MechatronixLab/ColorTemp/DOCUMENTS/ColorTemp PCB 3D Render.png

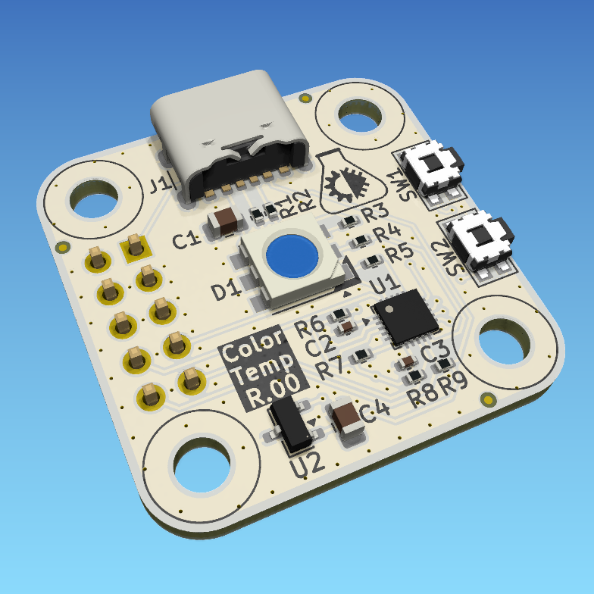
DOCUMENTS/ColorTemp PCB 3D Render.png
