MechatronixLab/ColorTemp/DOCUMENTS/ColorTemp PCB 3D Render Bottom.png

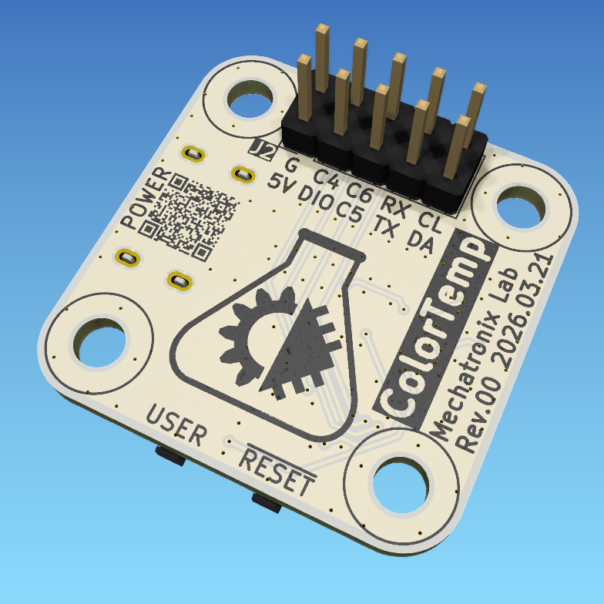
DOCUMENTS/ColorTemp PCB 3D Render Bottom.png
