MechatronixLab/ColorTemp/DOCUMENTS/ColorTemp GitHub Link QR.png

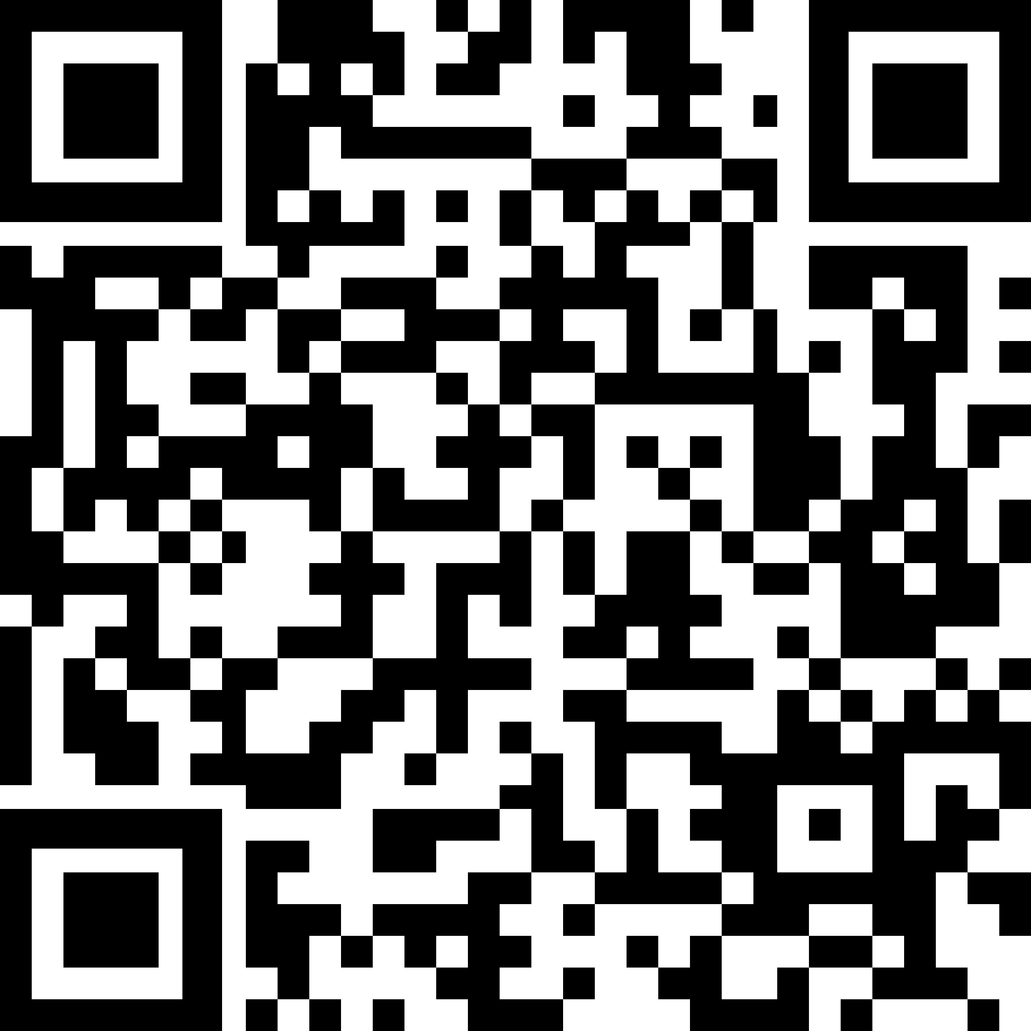
DOCUMENTS/ColorTemp GitHub Link QR.png
