MechatronixLab/ColorTemp/DOCUMENTS/ColorTemp PCB Bottom.png

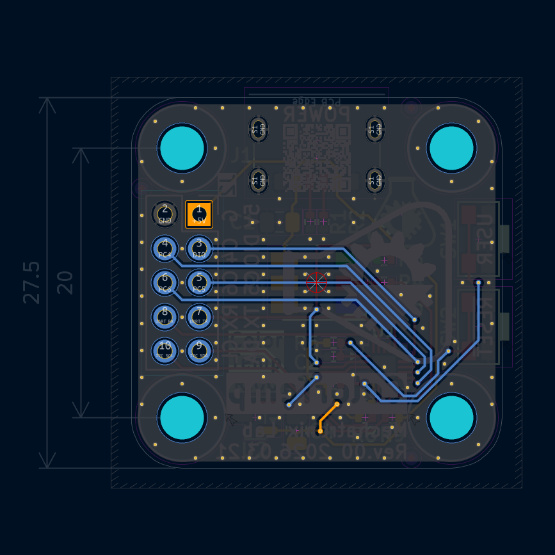
DOCUMENTS/ColorTemp PCB Bottom.png
