MechatronixLab/ColorTemp/DOCUMENTS/ColorTemp PCB Top.png

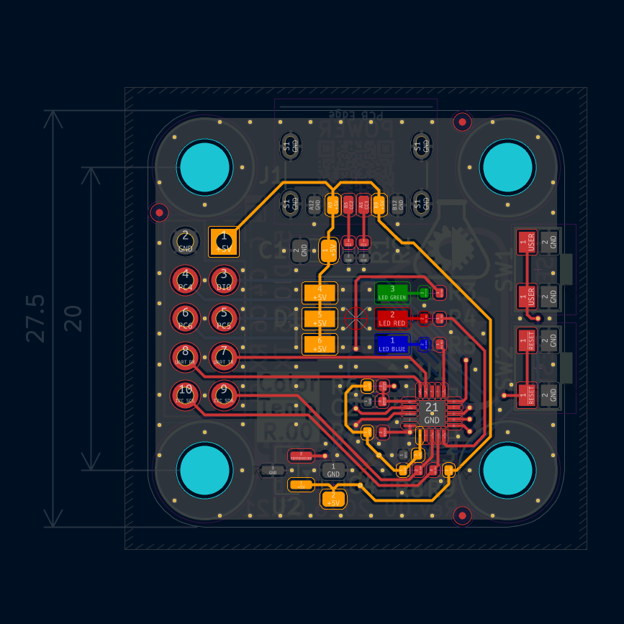
DOCUMENTS/ColorTemp PCB Top.png
