MechatronixLab/ColorTemp/HARDWARE/KICAD/Fabrication/ColorTemp Rev.00 - BOM (JLCPCB).xlsx

Comment | Designator | Footprint | JLCPCB Part # (optional)
10uF 25V | C1,C4 | C_0805_2012Metric | C15850
100nF 50V | C2,C3 | C_0402_1005Metric | C307331
WS2850B | D1 | WS2850B | C4154880
POWER | J1 | USB_C_Receptacle_GCT_USB4125-xx-x-0190_6P_TopMnt_Horizontal | C2927029
5.1K 1% | R1,R2,R6,R7,R8,R9 | R_0402_1005Metric | C25905
220R 1% | R3,R4,R5 | R_0402_1005Metric | C25091
USER | SW1 | EVQP7A01P | C79167
~{RESET} | SW2 | EVQP7A01P | C79167
CH32V003F4U6 | U1 | QFN-20-1EP_3x3mm_P0.4mm_EP1.65x1.65mm | C5299908
MCP9700A | U2 | SOT-23 | C127949
