MechatronixLab/ColorTemp/HARDWARE/KICAD/3D/EVQP7A01P.stp

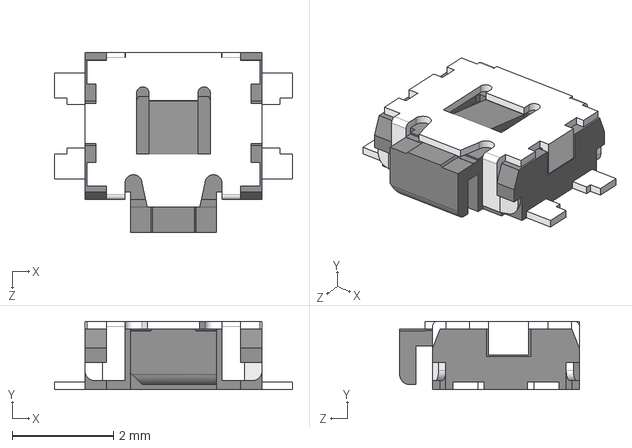
[picture p6: CAD file, 2026-03-14]
HARDWARE/KICAD/3D/EVQP7A01P.stp
4.70 x 1.35 x 3.55 mm
