MechatronixLab/ColorTemp/MECHANICAL/STEP/ColorTemp-PCB-Rev.00.step

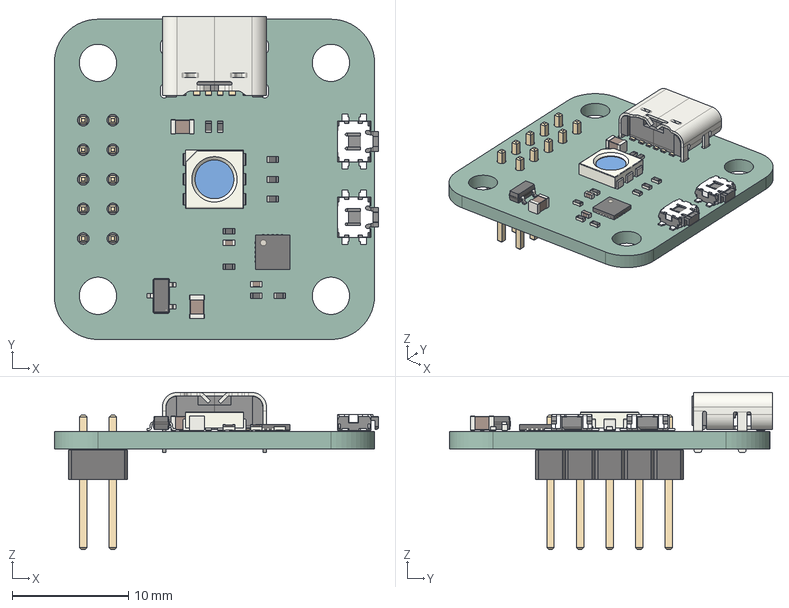
[picture p7: CAD file, 2026-03-14]
MECHANICAL/STEP/ColorTemp-PCB-Rev.00.step
27.9 x 27.7 x 13.5 mm
R_0402_1005Metric x 9
C_0805_2012Metric x 2
LED_RGB_5050-6
C_0402_1005Metric x 2
EVQP7A01P x 2
SOT-23
USB_C_Receptacle_GCT_USB4125-xx-x-0190_6P_TopMnt_Horizontal
UQFN-20-1EP_3x3mm_P0.4mm_EP1.85x1.85mm
PinHeader_2x05_P2.54mm_Vertical
ColorTemp_PCB
