MechatronixLab/ColorTemp/HARDWARE/KICAD/Fabrication/PDF/ColorTemp Rev.00 - SCHEMATIC.pdf

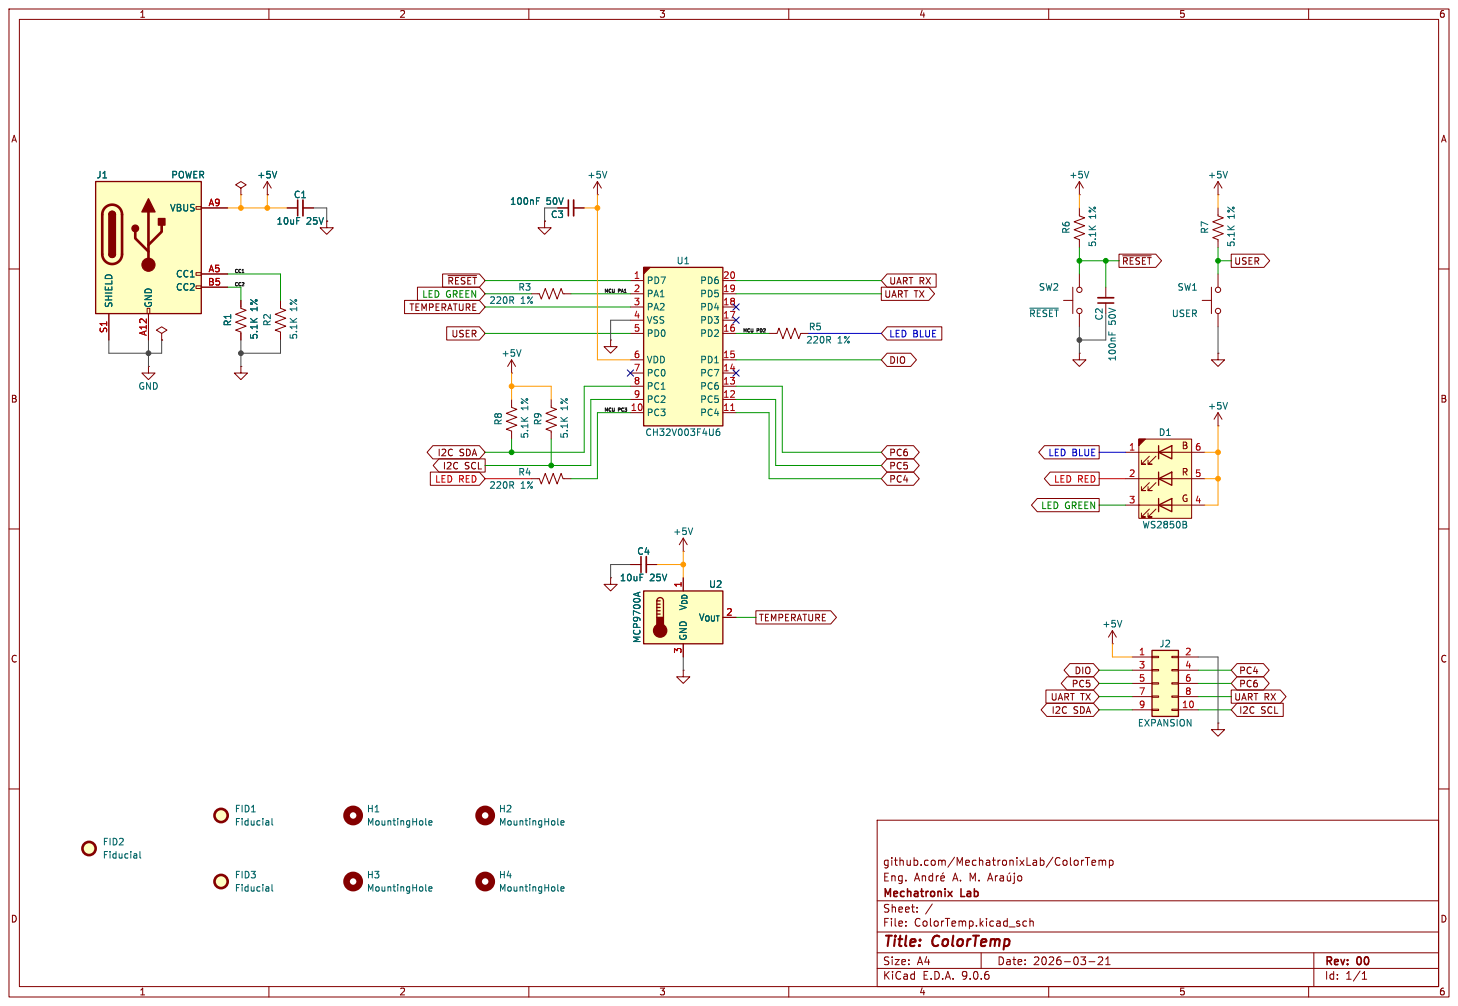
[picture p8: page 1]

I2C SCL PC4 UART RX UART TX

github.com/MechatronixLab/ColorTemp
