MechatronixLab/ColorTemp/HARDWARE/KICAD/Fabrication/PDF/ColorTemp Rev.00 - LAYOUT.pdf

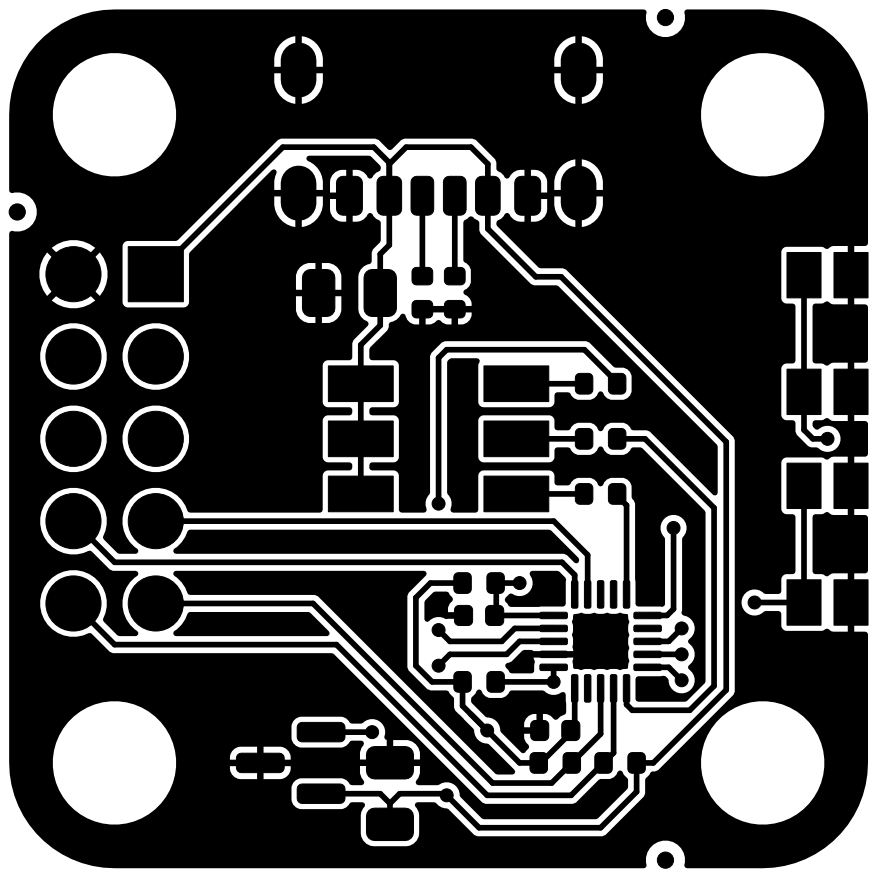
[picture p9: page 1]

github.com/MechatronixLab/ColorTemp

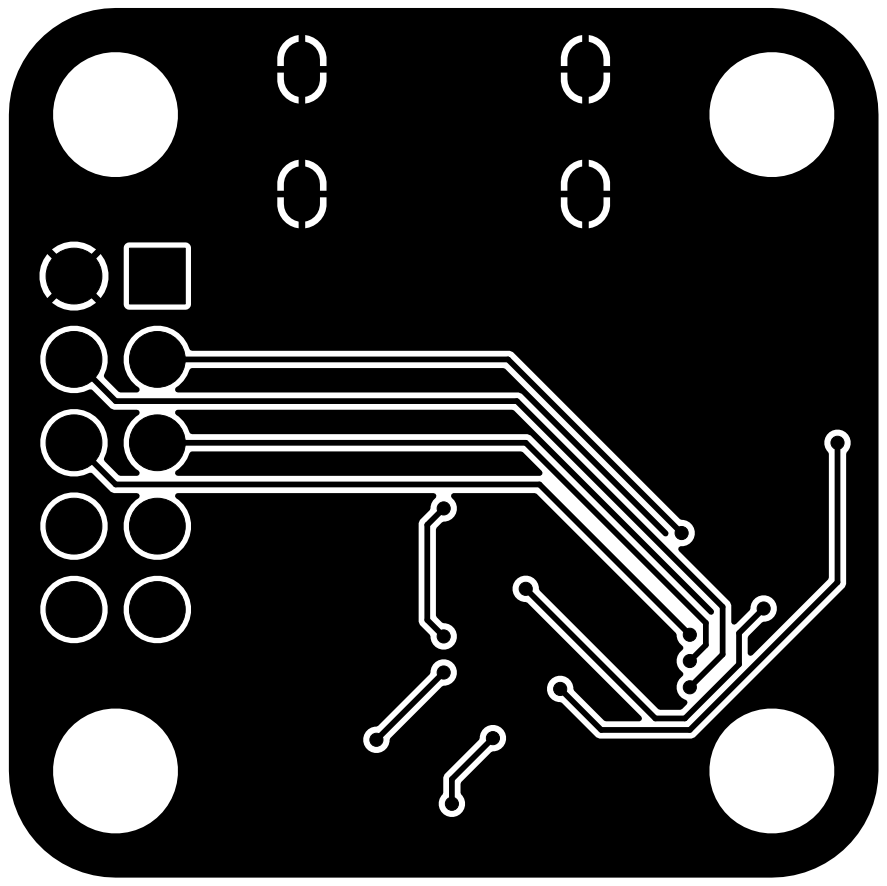
[picture p10: page 2]

github.com/MechatronixLab/ColorTemp

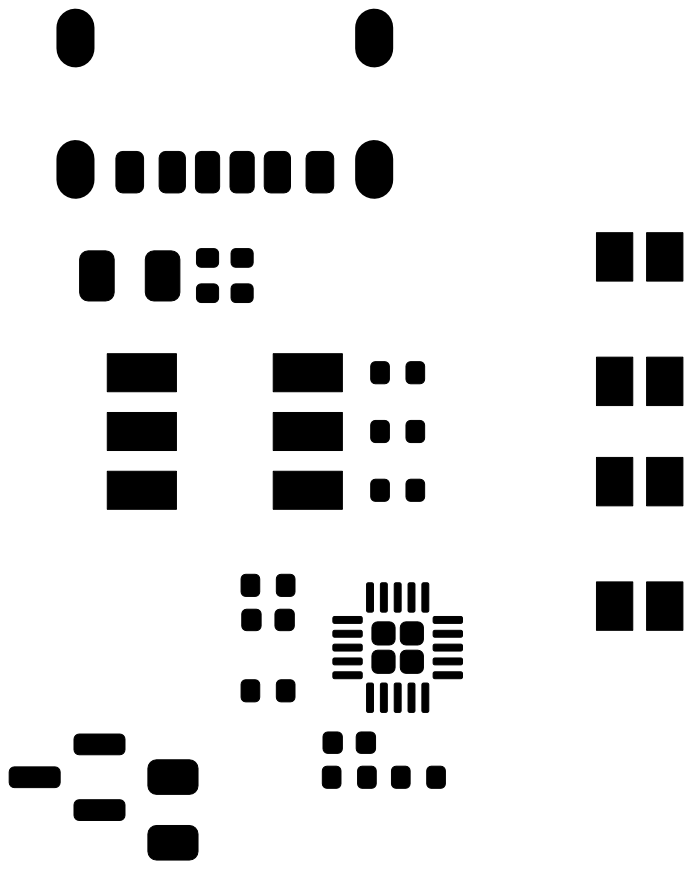
[picture p11: page 3]

github.com/MechatronixLab/ColorTemp

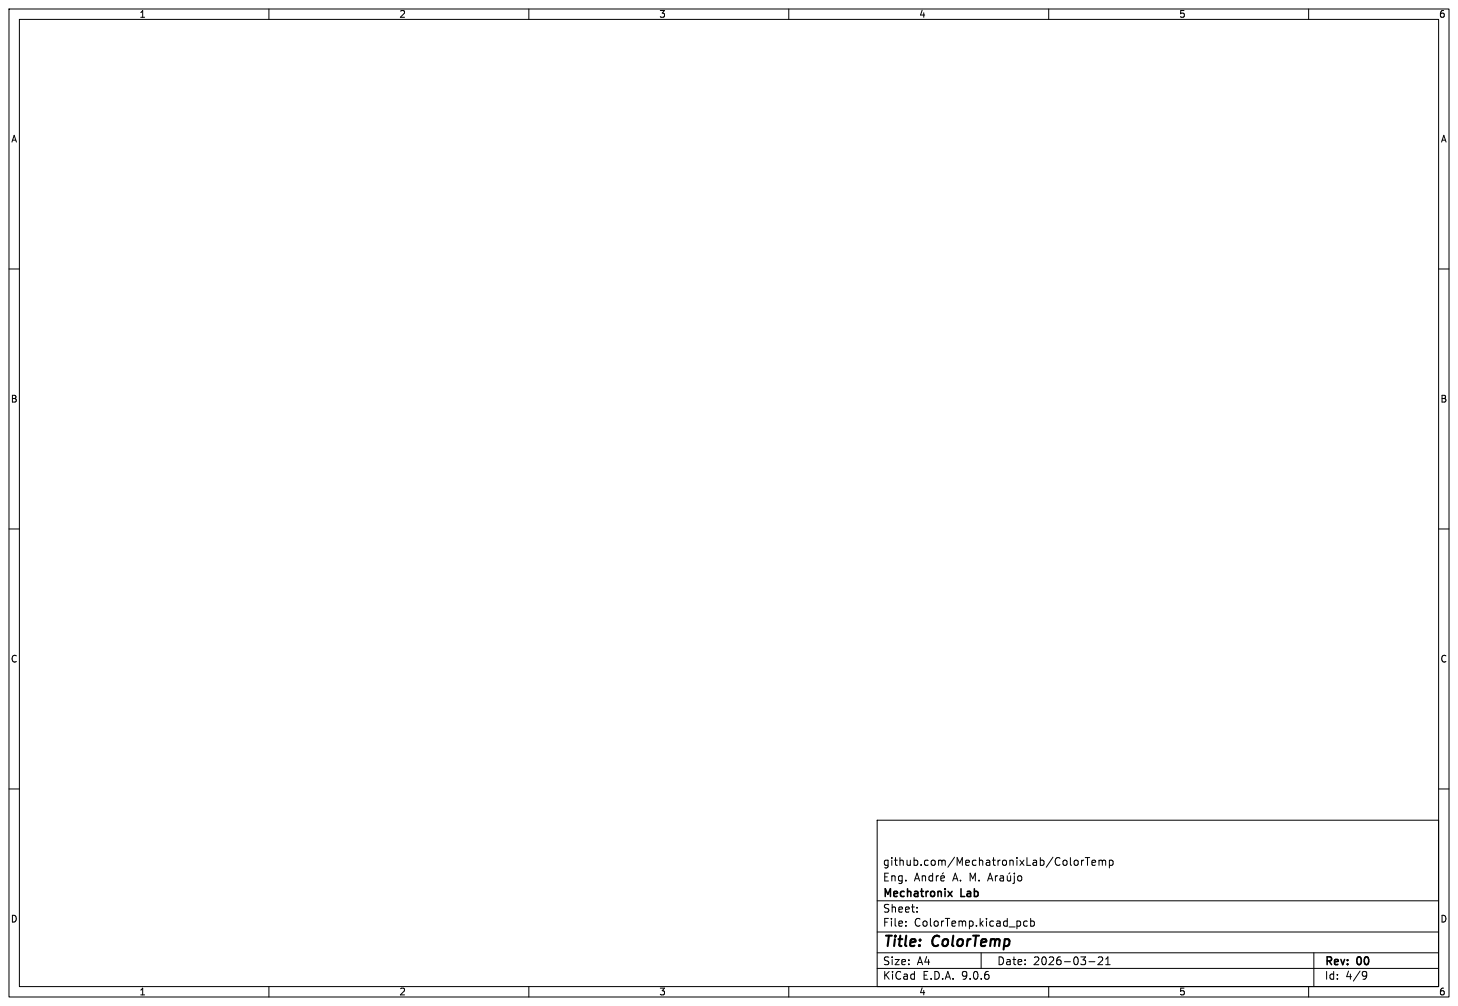
[picture p12: page 4]

github.com/MechatronixLab/ColorTemp

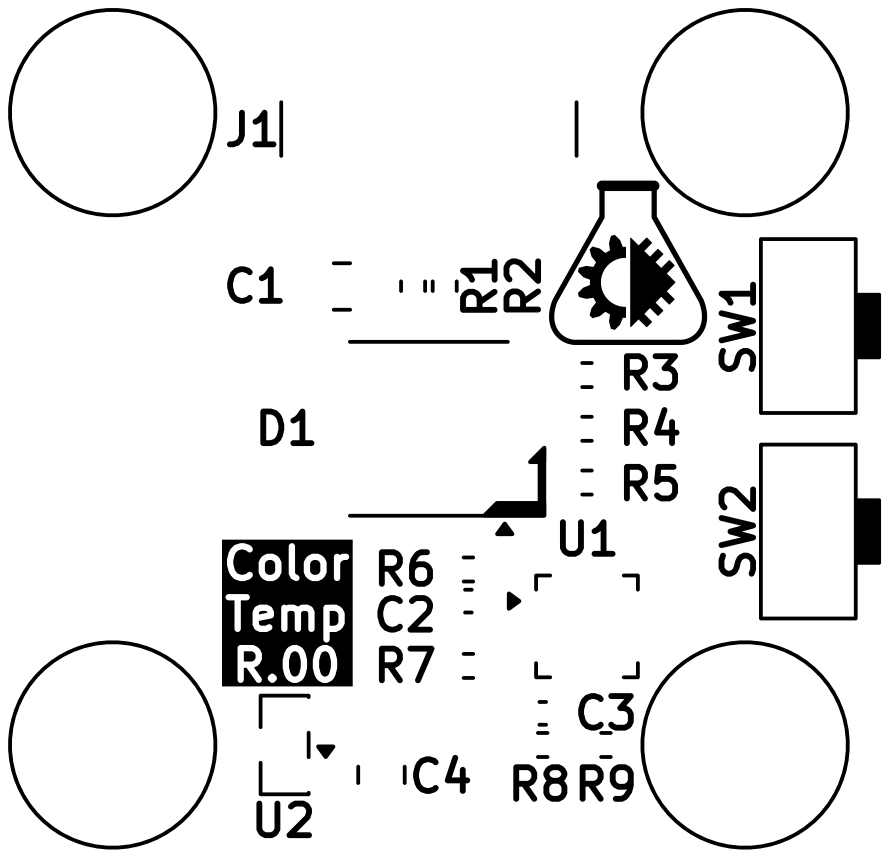
[picture p13: page 5]

github.com/MechatronixLab/ColorTemp

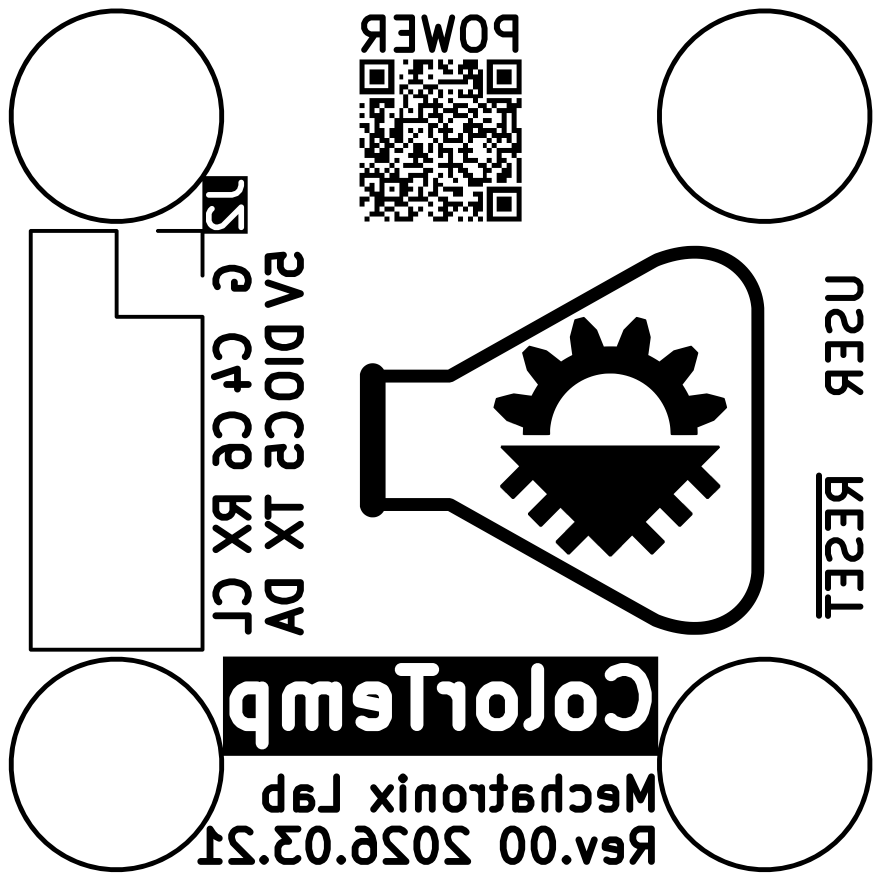
[picture p14: page 6]

github.com/MechatronixLab/ColorTemp

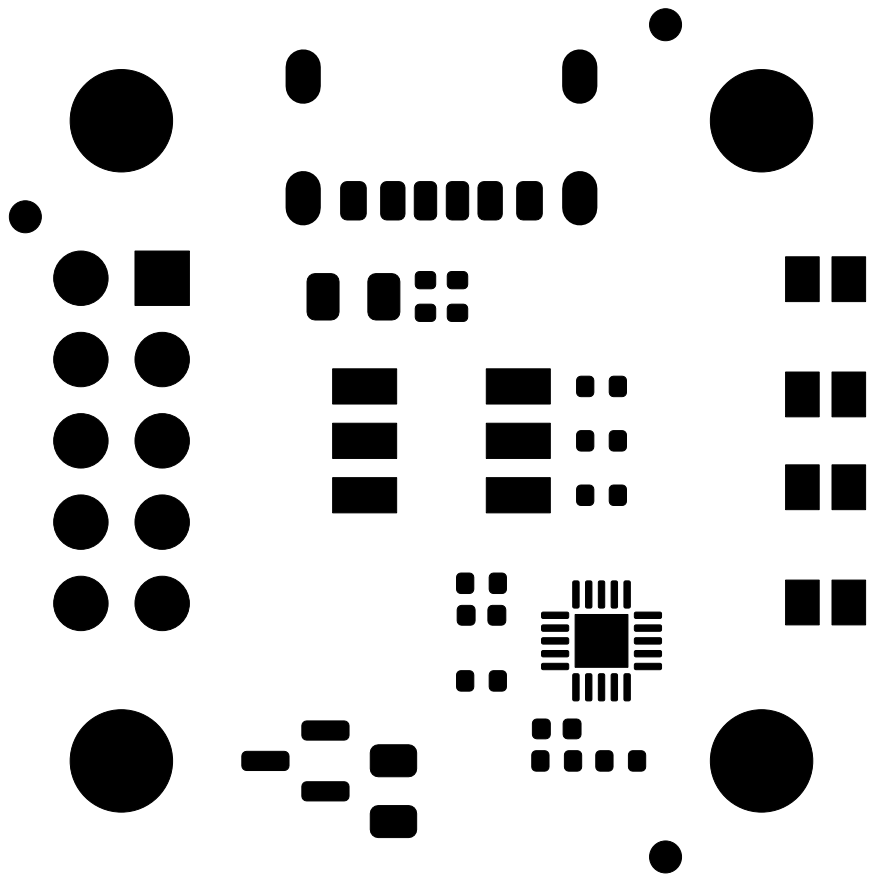
[picture p15: page 7]

github.com/MechatronixLab/ColorTemp

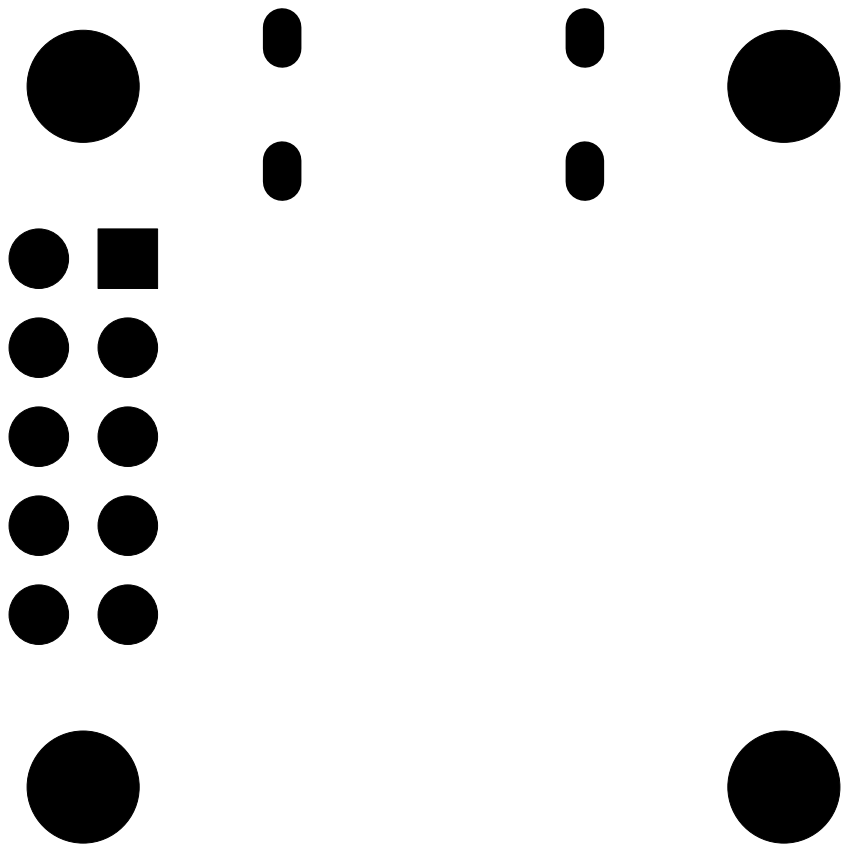
[picture p16: page 8]

github.com/MechatronixLab/ColorTemp

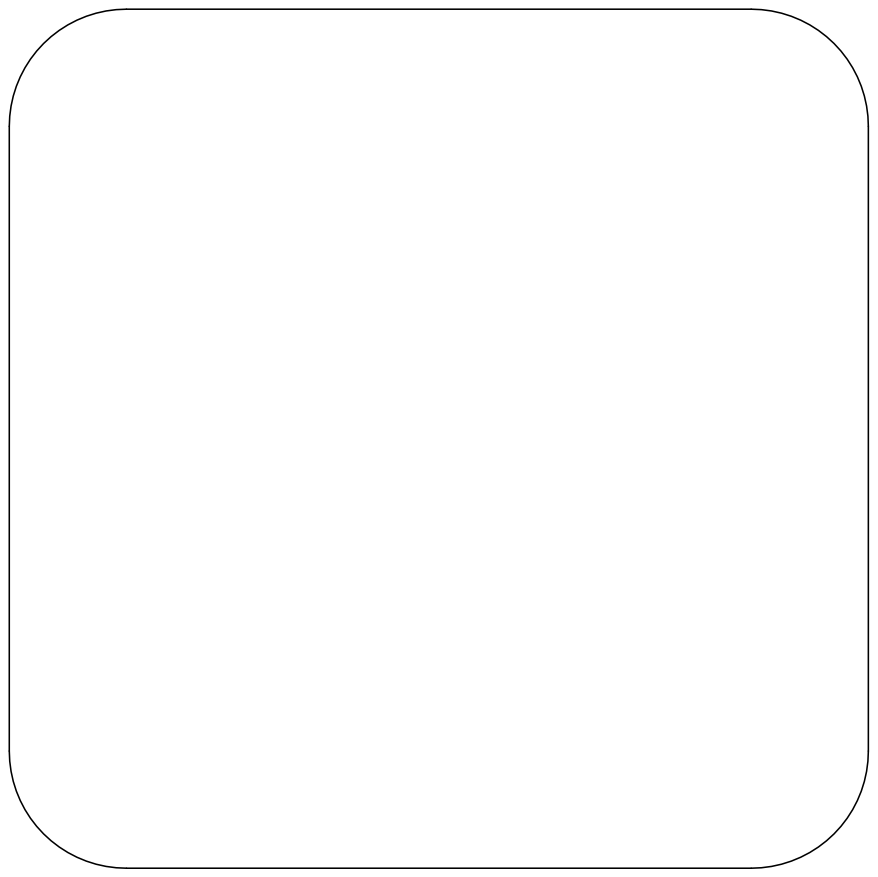
[picture p17: page 9]

github.com/MechatronixLab/ColorTemp
