MechatronixLab/ColorTemp/HARDWARE/KICAD/ColorTemp.kicad_pcb

## KiCad design HARDWARE/KICAD/ColorTemp.kicad_pcb (2026-03-21)

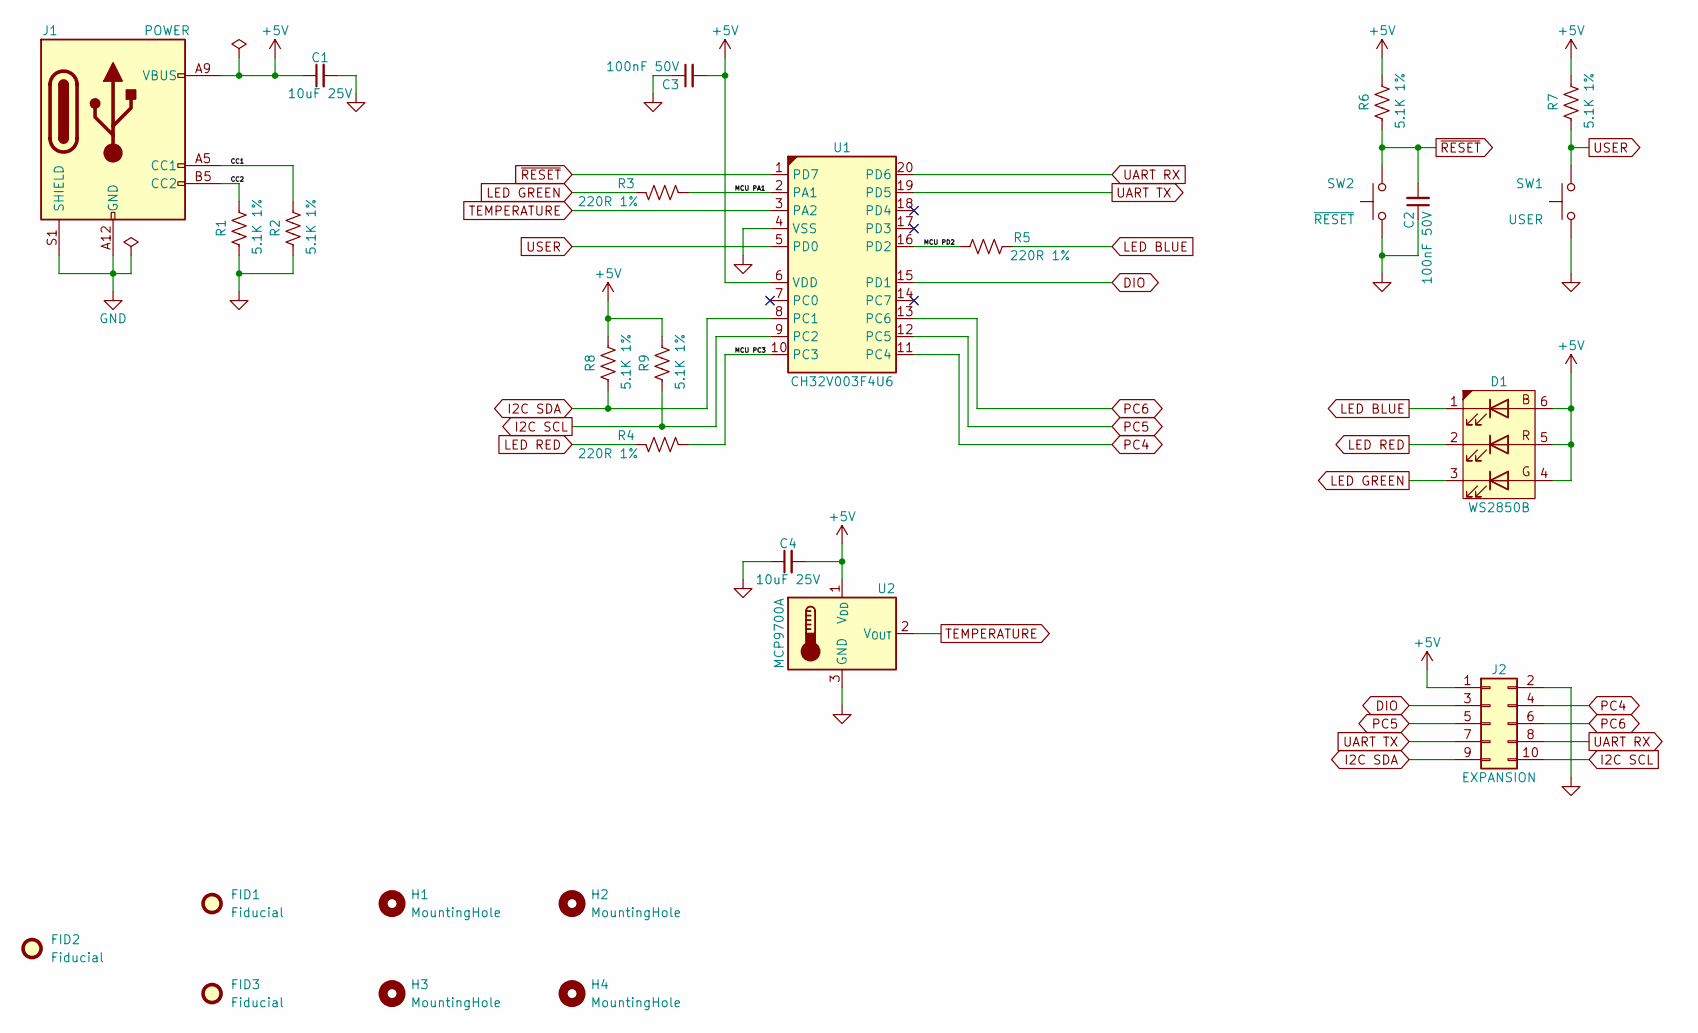
[picture p18: schematic ColorTemp.kicad_sch]

Parts:
C1, C4: 10uF 25V; C_0805_2012Metric; Part Number CL21A106KAYNNNE; JLCPCB C15850
C2, C3: 100nF 50V; C_0402_1005Metric; Part Number CL05B104KB54PNC; JLCPCB C307331
D1: WS2850B; Part Number WS2850B; JLCPCB C4154880
FID1, FID2, FID3: Fiducial; Fiducial_0.5mm_Mask1mm
H1, H2, H3, H4: MountingHole; MountingHole_3.2mm_M3
J1: POWER; USB_C_Receptacle_GCT_USB4125-xx-x-0190_6P_TopMnt_Horizontal; Part Number USB-TYPE-C-009; JLCPCB C2927029
J2: EXPANSION; PinHeader_2x05_P2.54mm_Vertical
R1, R2, R6, R7, R8, R9: 5.1K 1%; R_0402_1005Metric; Part Number 0402WGF5101TCE; JLCPCB C25905
R3, R4, R5: 220R 1%; R_0402_1005Metric; Part Number 0402WGF2200TCE; JLCPCB C25091
SW1: USER; EVQP7A01P; Part Number EVQP7A01P; JLCPCB C79167
SW2: ~{RESET}; EVQP7A01P; Part Number EVQP7A01P; JLCPCB C79167
U1: CH32V003F4U6; QFN-20-1EP_3x3mm_P0.4mm_EP1.65x1.65mm; Part Number CH32V003F4U6; JLCPCB C5299908
U2: MCP9700A; SOT-23; Part Number MCP9700AT-E/TT; JLCPCB C127949

Connections:
+5V: C1.1, C3.2, C4.2, D1.4 (K), D1.5 (K), D1.6 (K), J1.A9 (VBUS), J1.B9 (VBUS), J2.1, R6.1, R7.1, R8.1, R9.1, U1.6 (VDD), U2.1 (V_{DD})
/CC1: J1.A5 (CC1), R2.1
/CC2: J1.B5 (CC2), R1.1
/MCU PA1: R3.1, U1.2 (PA1)
/MCU PC3: R4.1, U1.10 (PC3)
/MCU PD2: R5.1, U1.16 (PD2)
DIO: J2.3, U1.15 (PD1)
GND: C1.2, C2.1, C3.1, C4.1, J1.A12 (GND), J1.B12 (GND), J1.S1 (SHIELD), J2.2, R1.2, R2.2, SW1.2, SW2.2, U1.4 (VSS), U1.21 (VSS), U2.3 (GND)
I2C SCL: J2.10, R9.2, U1.9 (PC2)
I2C SDA: J2.9, R8.2, U1.8 (PC1)
LED BLUE: D1.1 (A), R5.2
LED GREEN: D1.3 (A), R3.2
LED RED: D1.2 (A), R4.2
PC4: J2.4, U1.11 (PC4)
PC5: J2.5, U1.12 (PC5)
PC6: J2.6, U1.13 (PC6)
TEMPERATURE: U1.3 (PA2), U2.2 (V_{OUT})
UART RX: J2.8, U1.20 (PD6)
UART TX: J2.7, U1.19 (PD5)
USER: R7.2, SW1.1, U1.5 (PD0)
~RESET: C2.2, R6.2, SW2.1, U1.1 (PD7)

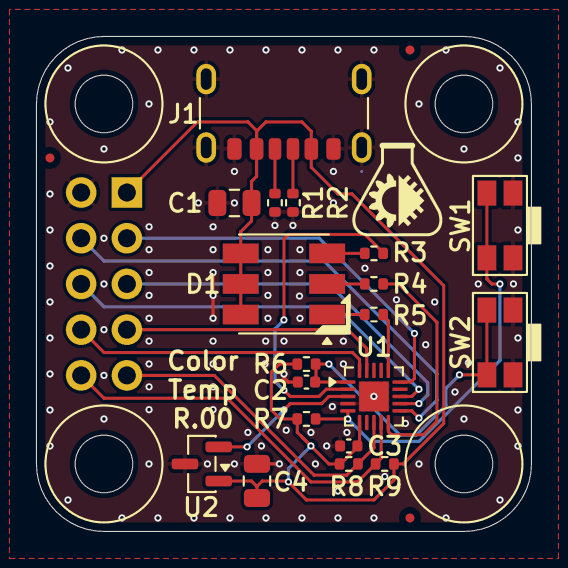
[picture p19: board ColorTemp.kicad_pcb from above]

Board: 2 copper layers, 27.5 x 27.5 mm, 27 parts (1 on the bottom side), 21 nets.
