MechatronixLab/ColorTemp/FIRMWARE/App/Inc/temperaure.h

#ifndef INC_TEMPERATURE_H_
#define INC_TEMPERATURE_H_

#include "ch32v00x.h"

#define ADC_VDD_mV   5000   // VDD in mV

#define CHAR_DEGREE "\xB0"  // ?

void TEMPERATURE_Init(void);
int16_t TEMPERATURE_GetT_dC(void);

#endif /* INC_TEMPERATURE_H_ */
