MechatronixLab/ColorTemp/(commit log)

2026-03-07 Updating .gitignore for unnecessary KiCad files.
2026-03-07 Created PCB project.
    [ColorTemp.kicad_pcb, ColorTemp.kicad_sch]
2026-03-07 Advancing on parts creation.
    [ColorTemp.kicad_pcb, ColorTemp.kicad_sch]
2026-03-09 Added most of the components. Recently project started crashing on PCB, when I press X to route. I'll try to restore a backup.
    [ColorTemp.kicad_pcb, ColorTemp.kicad_sch]
2026-03-09 Restored working project.
    [ColorTemp.kicad_pcb, ColorTemp.kicad_sch]
2026-03-09 Project restored and back to normal. Added signals to external connector.
    [ColorTemp.kicad_pcb, ColorTemp.kicad_sch]
2026-03-14 Removed transistors for driving LED. Advanced circuit and layout design. Added switches.
    [ColorTemp.kicad_pcb, ColorTemp.kicad_sch, EVQP7A01P.stp]
2026-03-14 Detailing layout and silkscreen.
    [ColorTemp.kicad_pcb, ColorTemp.kicad_sch]
2026-03-14 Preliminary PCB design done. Will now begin mechanical design.
    [ColorTemp.kicad_pcb]
2026-03-14 Started mechanical design.
    [ColorTemp-PCB-Rev.00.cfg, ColorTemp-PCB-Rev.00.step, ColorTemp.cfg]
2026-03-15 Added fiducial marks.
    [ColorTemp.cfg, ColorTemp.kicad_pcb, ColorTemp.kicad_sch]
2026-03-15 Renumbering, PWR_FLAG, schematic detailing.
    [ColorTemp.kicad_pcb, ColorTemp.kicad_sch]
2026-03-21 Finished schematic.
    [ColorTemp.kicad_pcb, ColorTemp.kicad_sch]
2026-03-21 Fixed line widths to standardize at 0.12mm.
2026-03-21 Finished Schematic and PCB Design.
    [ColorTemp.kicad_pcb]
2026-03-21 Generated Gerber files and PDF.
2026-03-21 Updated gitignore to track Gerber files.
2026-03-21 Regenerated Gerber and drill files.
    [ColorTemp-B_Cu.gbr, ColorTemp-B_Mask.gbr, ColorTemp-B_Paste.gbr, ColorTemp-B_Silkscreen.gbr, ColorTemp-Edge_Cuts.gbr, ColorTemp-F_Cu.gbr, ColorTemp-F_Mask.gbr, ColorTemp-F_Paste.gbr]
2026-03-21 Generated BOM and placement files. Updated detail on 220R in component library.
    [ColorTemp.csv, ColorTemp.kicad_sch]
2026-03-21 Generated BOM and Pick and Place files.
    [ColorTemp - BOM (JLCPCB).xlsx, ColorTemp - PICK AND PLACE (JLCPCB).xlsx, ColorTemp.csv, ColorTemp.kicad_sch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]
2026-03-21 Added QR code on PCB and links to sheets.
    [ColorTemp.kicad_pcb, ColorTemp.kicad_sch]
2026-03-21 Regenerated fabrication files after adding QR code to PCB.
    [ColorTemp Rev.00 - PICK AND PLACE (JLCPCB).xlsx, ColorTemp Rev.00 - BOM (JLCPCB).xlsx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]
2026-03-21 Had to replace de LED because it was not in Economic fabrication at JLC.
    [ColorTemp-B_Cu.gbr, ColorTemp-B_Mask.gbr, ColorTemp-B_Paste.gbr, ColorTemp-B_Silkscreen.gbr, ColorTemp-Edge_Cuts.gbr, ColorTemp-F_Cu.gbr, ColorTemp-F_Mask.gbr, ColorTemp-F_Paste.gbr]
2026-03-21 Regenerated fabrication files after LED replacement.
    [ColorTemp Rev.00 - PICK AND PLACE (JLCPCB).xlsx, ColorTemp Rev.00 - BOM (JLCPCB).xlsx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]
2026-03-21 Fixed incorrect PN on 5.1K resistors.
    [ColorTemp Rev.00 - PICK AND PLACE (JLCPCB).xlsx, ColorTemp Rev.00 - BOM (JLCPCB).xlsx, ColorTemp Rev.00 - PICK AND PLACE (JLCPCB).xlsx, ColorTemp.csv, ColorTemp.kicad_pcb, ColorTemp.kicad_sch]
2026-03-22 Testing JLC 3DPrinting services. Added a few images.
    [ColorTemp.cfg]
2026-04-15 Reworked the code to work with the PCB (inverted LED logic and added temperature sensor offset).
    [app.c, led.c, temperature.c]
2026-05-01 Added function to map Temperature do Color.
    [TEMPERATURE-TO-COLOR-MAP.xlsx]
2026-05-03 Extended smooth transitions beyond -20 and +60 degrees C.
    [TEMPERATURE-TO-COLOR-MAP.xlsx]
2026-05-05 Added support for used button.
2026-05-05 Added mode selection and LED sweep. Needs refactoring.
